pierre-muth/solo-nixie/kicad/solo-nixie/micro-usb.stp

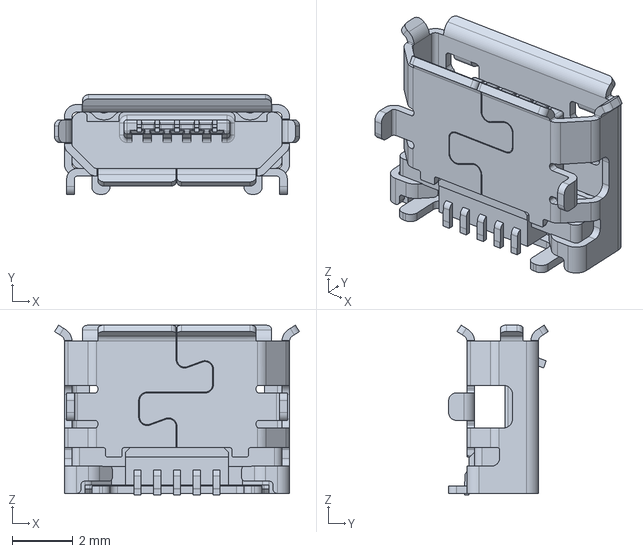
[picture p2: CAD file, 2021-12-10]
kicad/solo-nixie/micro-usb.stp
8.05 x 3.27 x 5.58 mm
