pierre-muth/solo-nixie/STL/solo-nixie-body.stl

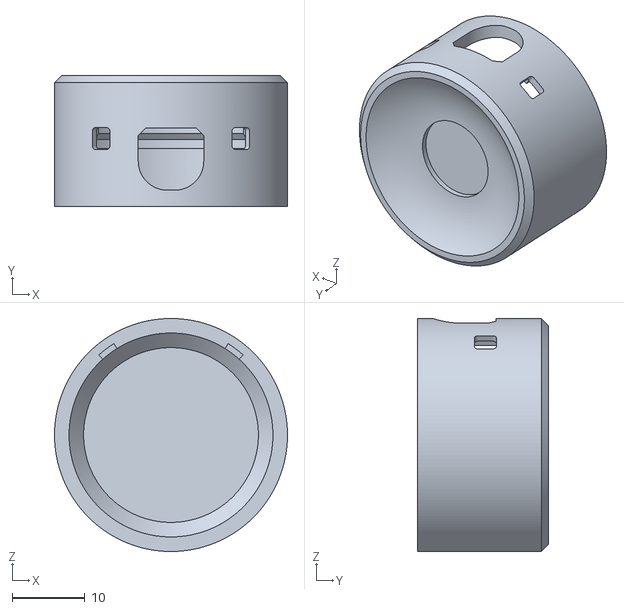
[picture p3: CAD file, 2021-12-10]
STL/solo-nixie-body.stl
32.0 x 18.0 x 32.0
