pierre-muth/solo-nixie/kicad/solo-nixie/text2.dxf

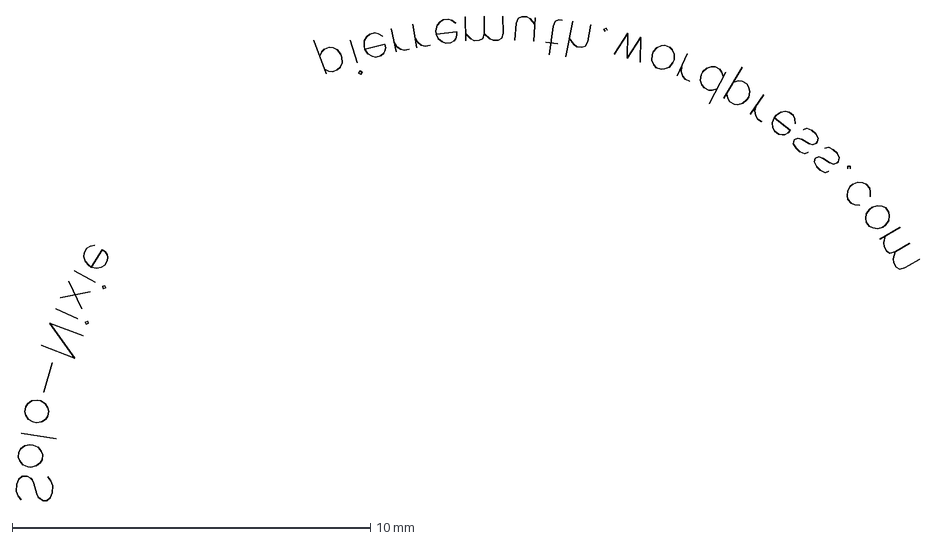
[picture p4: CAD file, 2021-12-10]
kicad/solo-nixie/text2.dxf
25.2 x 13.5 mm
