pierre-muth/solo-nixie/STL/clip.stl

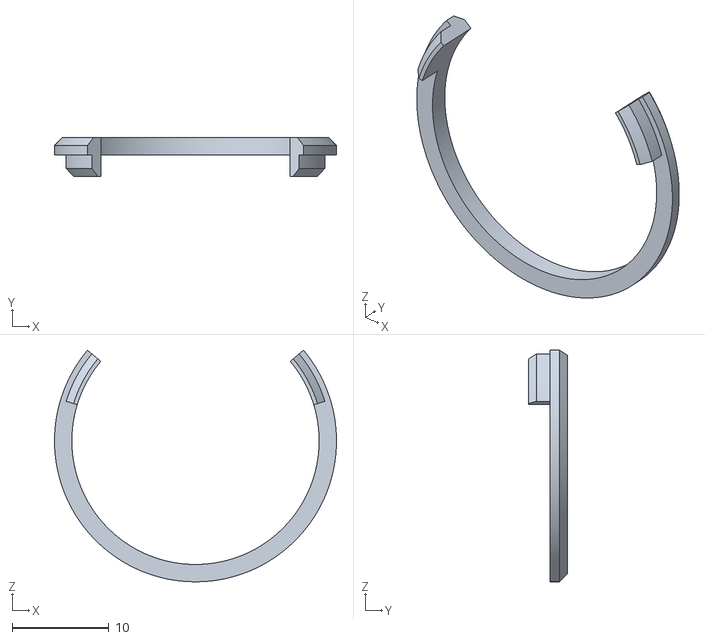
[picture p5: CAD file, 2021-12-10]
STL/clip.stl
29.2 x 4.00 x 24.0
