pierre-muth/solo-nixie/kicad/solo-nixie/text.dxf

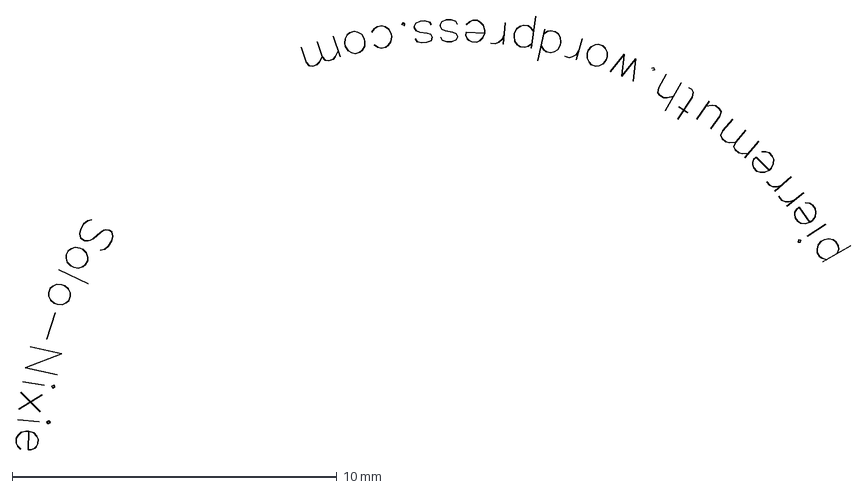
[picture p6: CAD file, 2021-12-10]
kicad/solo-nixie/text.dxf
25.7 x 13.3 mm
