pierre-muth/solo-nixie/STL/button.stl

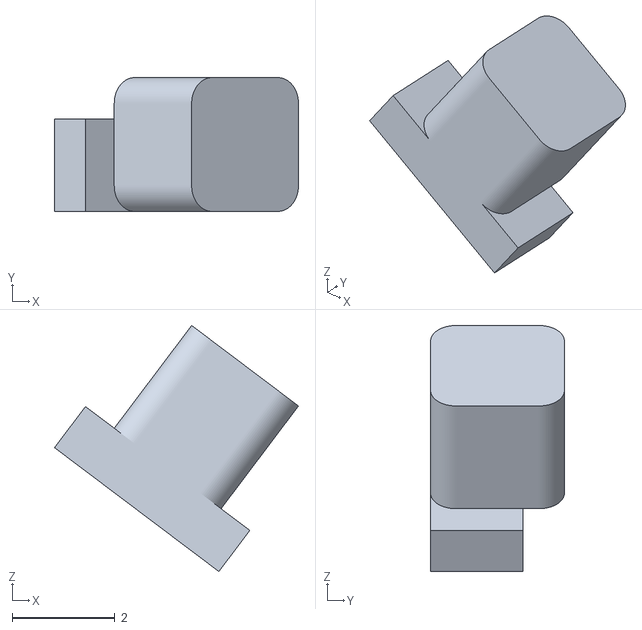
[picture p7: CAD file, 2021-12-10]
STL/button.stl
4.74 x 2.60 x 4.78
