pierre-muth/solo-nixie/kicad/solo-nixie/solo-nixie-B_Cu.dxf

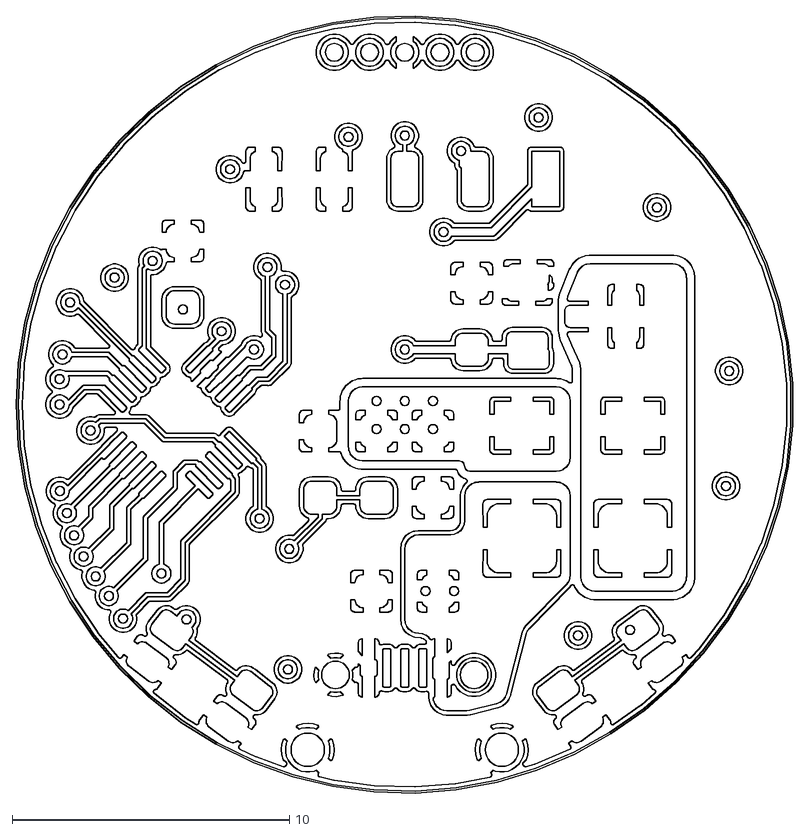
[picture p8: CAD file, 2021-12-10]
kicad/solo-nixie/solo-nixie-B_Cu.dxf
28.0 x 28.0
