pierre-muth/solo-nixie/kicad/solo-nixie/solo-nixie.kicad_pcb

## KiCad design kicad/solo-nixie/solo-nixie.kicad_pcb (2021-12-10)

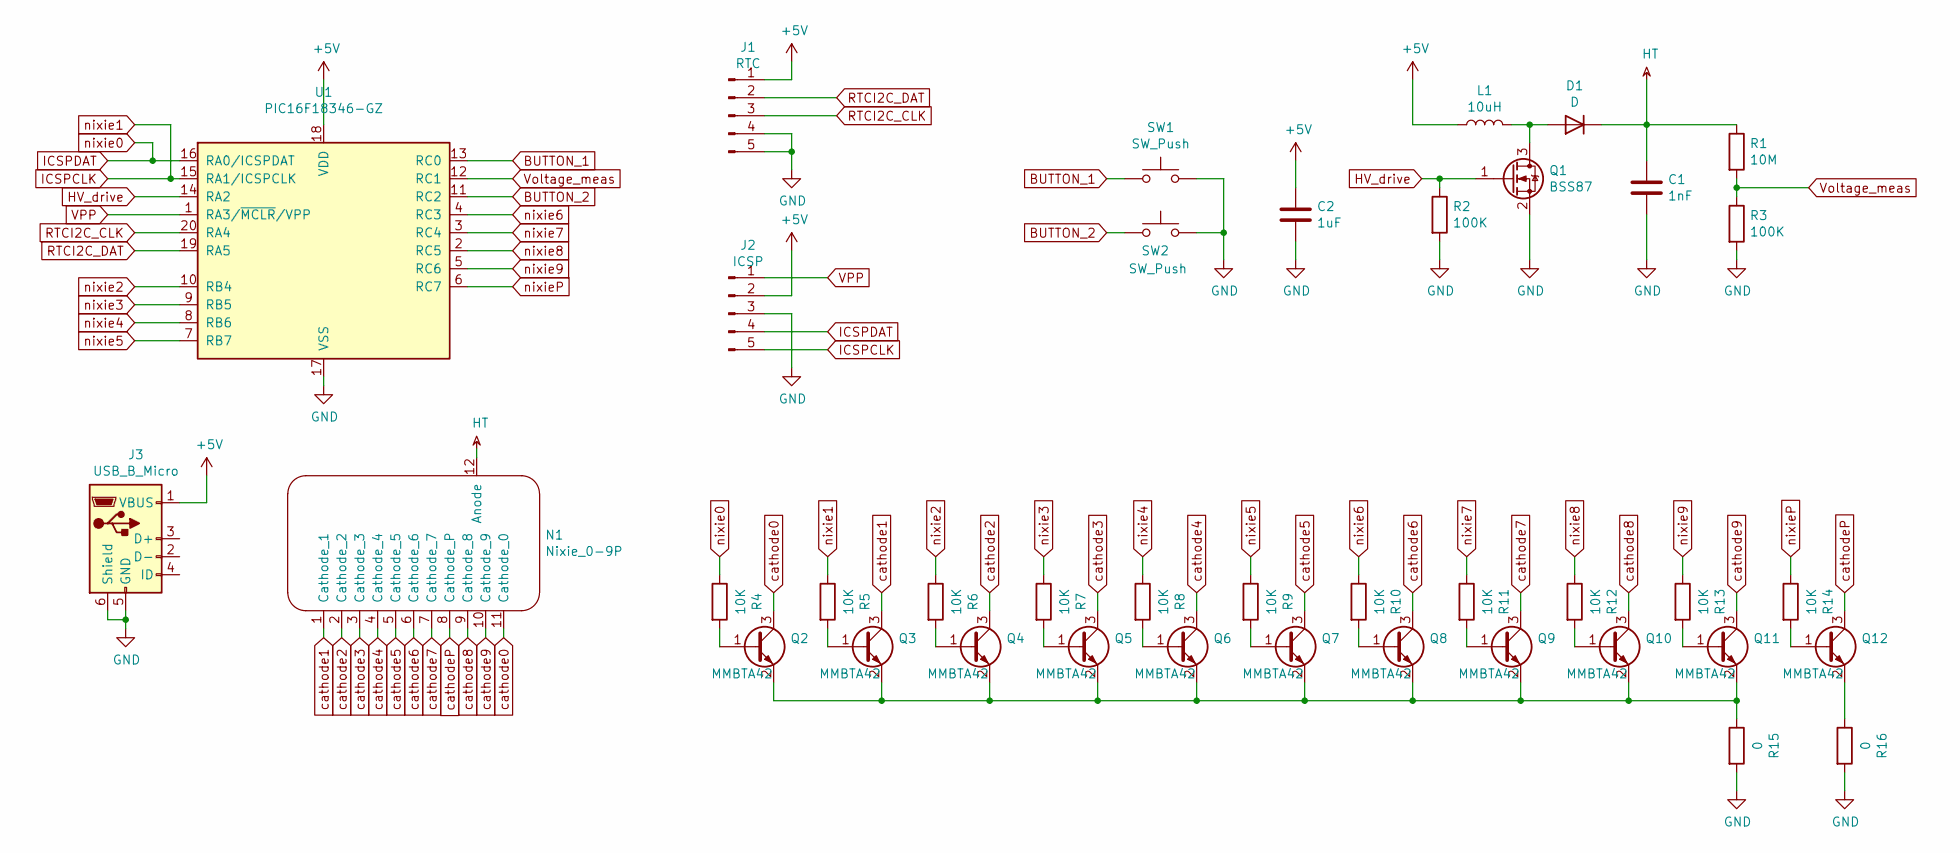
[picture p9: schematic solo-nixie.sch]

Parts:
C1: 1nF; 0805_HandSoldering
C2: 1uF; 0805_HandSoldering
D1: D; D_3220
J1: RTC; Pin_Header_RTC_5x2.54mm_SMD
J2: ICSP; PinHeader_1x05_P1.27mm_Vertical
J3: USB_B_Micro; USB_Micro-B_Wuerth-629105150521_CircularHoles
L1: 10uH; L_3216Metric
N1: Nixie_0-9P; LD8007
Q1: BSS87; CPH3
Q2, Q3, Q4, Q5, Q6, Q7, Q8, Q9, Q10, Q11, Q12: MMBTA42; SOT-23
R1: 10M; 0805_HandSoldering
R2, R3: 100K; 0805_HandSoldering
R4, R5, R6, R7, R8, R9, R10, R11, R12, R13, R14: 10K; 0805_HandSoldering
R15, R16: 0; 0805_HandSoldering
SW1, SW2: SW_Push; SW_SPST_EVQP7A
U1: PIC16F18346-GZ; UQFN-20-1EP_4x4mm_P0.5mm_EP2.8x2.8mm

Connections:
+5V: C2.1, J1.1, J2.2, J3.1 (VBUS), L1.1, U1.18 (VDD); also elsewhere on the board
BUTTON_1: SW1.1, U1.13 (RC0)
BUTTON_2: SW2.1, U1.11 (RC2)
GND: C1.2, C2.2, J1.4, J1.5, J2.3, J3.5 (GND), J3.6 (Shield), Q1.2 (S), R2.2, R3.2, R15.2, R16.2, SW1.2, SW2.2, U1.17 (VSS); also elsewhere on the board
HT: C1.1, D1.1 (K), N1.12 (Anode), R1.1
HV_drive: Q1.1 (G), R2.1, U1.14 (RA2)
ICSPCLK: J2.5, R5.1, U1.15 (RA1/ICSPCLK)
ICSPDAT: J2.4, R4.1, U1.16 (RA0/ICSPDAT)
unnamed: D1.2 (A), L1.2, Q1.3 (D)
unnamed: Q2.1 (B), R4.2
unnamed: Q3.1 (B), R5.2
unnamed: Q4.1 (B), R6.2
unnamed: Q5.1 (B), R7.2
unnamed: Q6.1 (B), R8.2
unnamed: Q7.1 (B), R9.2
unnamed: Q8.1 (B), R10.2
unnamed: Q9.1 (B), R11.2
unnamed: Q10.1 (B), R12.2
unnamed: Q2.2 (E), Q3.2 (E), Q4.2 (E), Q5.2 (E), Q6.2 (E), Q7.2 (E), Q8.2 (E), Q9.2 (E), Q10.2 (E), Q11.2 (E), R15.1
unnamed: Q11.1 (B), R13.2
unnamed: Q12.1 (B), R14.2
unnamed: Q12.2 (E), R16.1
RTCI2C_CLK: J1.3, U1.20 (RA4); also elsewhere on the board
RTCI2C_DAT: J1.2, U1.19 (RA5); also elsewhere on the board
VPP: J2.1, U1.1 (RA3/~MCLR~/VPP)
Voltage_meas: R1.2, R3.1, U1.12 (RC1)
cathode0: N1.11 (Cathode_0), Q2.3 (C)
cathode1: N1.1 (Cathode_1), Q3.3 (C)
cathode2: N1.2 (Cathode_2), Q4.3 (C)
cathode3: N1.3 (Cathode_3), Q5.3 (C)
cathode4: N1.4 (Cathode_4), Q6.3 (C)
cathode5: N1.5 (Cathode_5), Q7.3 (C)
cathode6: N1.6 (Cathode_6), Q8.3 (C)
cathode7: N1.7 (Cathode_7), Q9.3 (C)
cathode8: N1.9 (Cathode_8), Q10.3 (C)
cathode9: N1.10 (Cathode_9), Q11.3 (C)
cathodeP: N1.8 (Cathode_P), Q12.3 (C)
nixie2: R6.1, U1.10 (RB4)
nixie3: R7.1, U1.9 (RB5)
nixie4: R8.1, U1.8 (RB6)
nixie5: R9.1, U1.7 (RB7)
nixie6: R10.1, U1.4 (RC3)
nixie7: R11.1, U1.3 (RC4)
nixie8: R12.1, U1.2 (RC5)
nixie9: R13.1, U1.5 (RC6)
nixieP: R14.1, U1.6 (RC7)

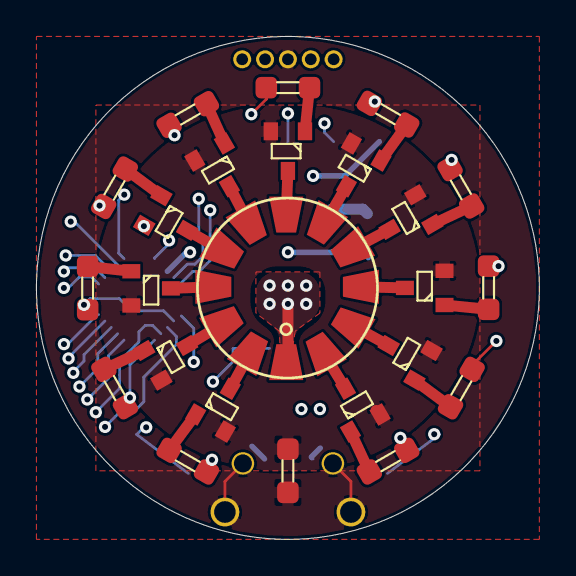
[picture p10: board solo-nixie.kicad_pcb from above]

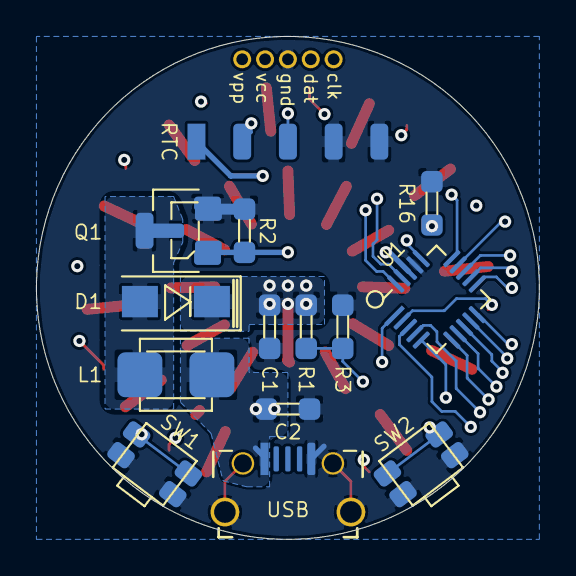
[picture p11: board solo-nixie.kicad_pcb from below]

Board: 4 copper layers, 27.9 x 27.9 mm, 39 parts (15 on the bottom side), 46 nets.

Other parts of the board:
RTC: RTC; Pin_Header_RTC_5x2.54mm_SMD
USB: USB_B_Micro; USB_Micro-B_Wuerth-629105150521_CircularHoles

Their connections:
+5V: RTC.1, USB.1; also elsewhere on the board
GND: RTC.4, RTC.5, USB.5, USB.6; also elsewhere on the board
RTCI2C_CLK: RTC.3; also elsewhere on the board
RTCI2C_DAT: RTC.2; also elsewhere on the board
